estsamanthazota-cmd/Laboratorio-1-Robotica-UMNG/OperadorHumano/README.md

En este apartado se encontrara el diagrama de bloques correspondiente a la interfaz grafica del proceso del ensamble

Se encuentran las señales de inicio de la secuencia como el home de cada uno de los manipuladores.

Se monitorea cada una de los procesos realizados por los ensambladores como de los transportadores.

Se evalua el estado de la caja como de los pin pones
