estsamanthazota-cmd/Laboratorio-1-Robotica-UMNG/OperadorHumano/DiagramaDeBloques.pdf

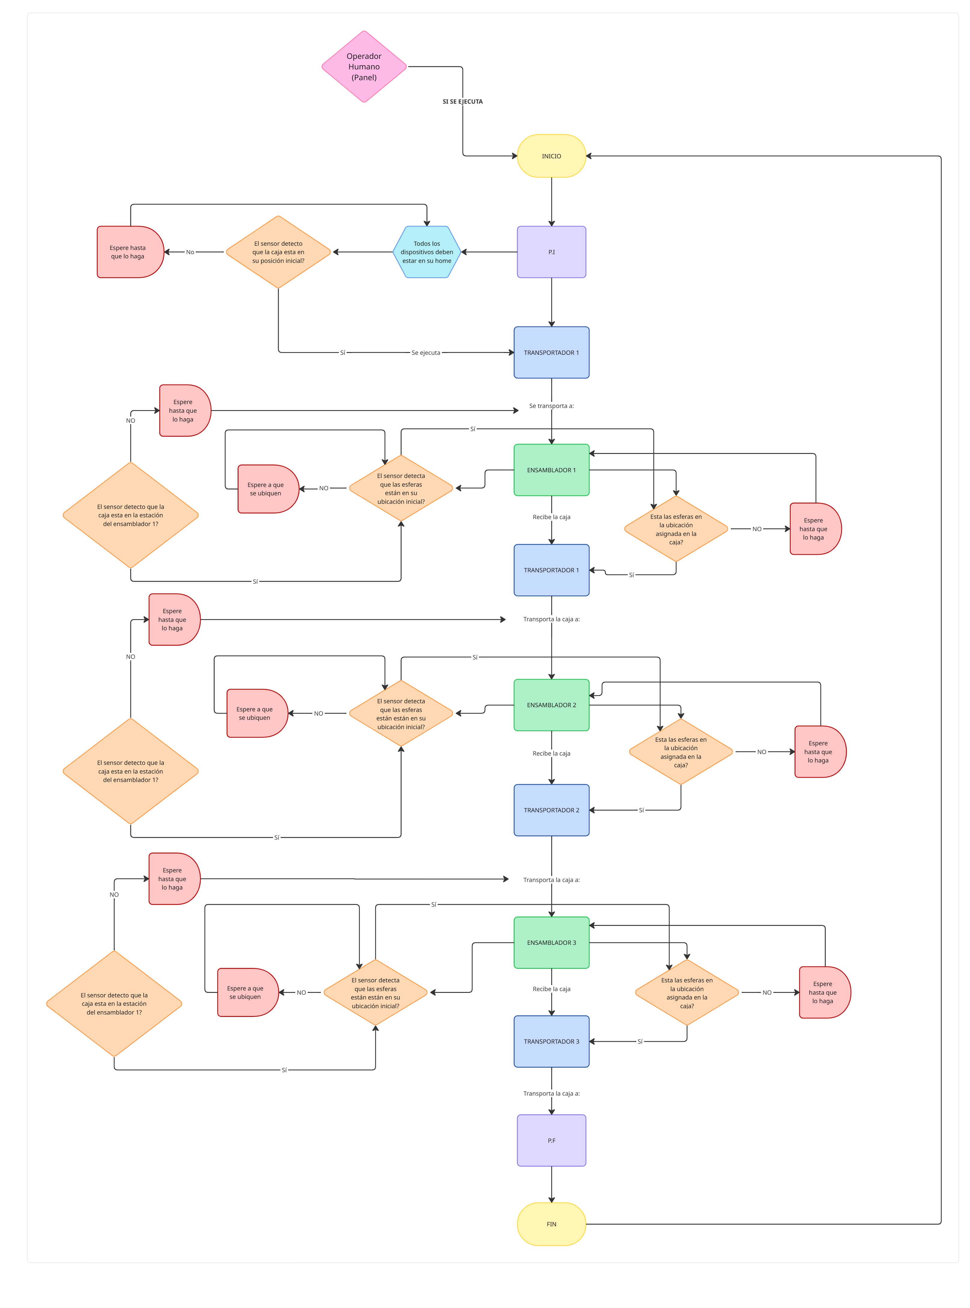
[picture p3: page 1]
