estsamanthazota-cmd/Laboratorio-1-Robotica-UMNG/Transportador 1/Brazo/Planos/Planos Brazo Robotico.pdf

TRANSPORTADOR N° 1

Hecho por:

Johan Nicolas Moreno Sabogal

Juan David Romero Prieto

Juan Esteban Betancourt Amado

Samir Esteban Jiménez Arias

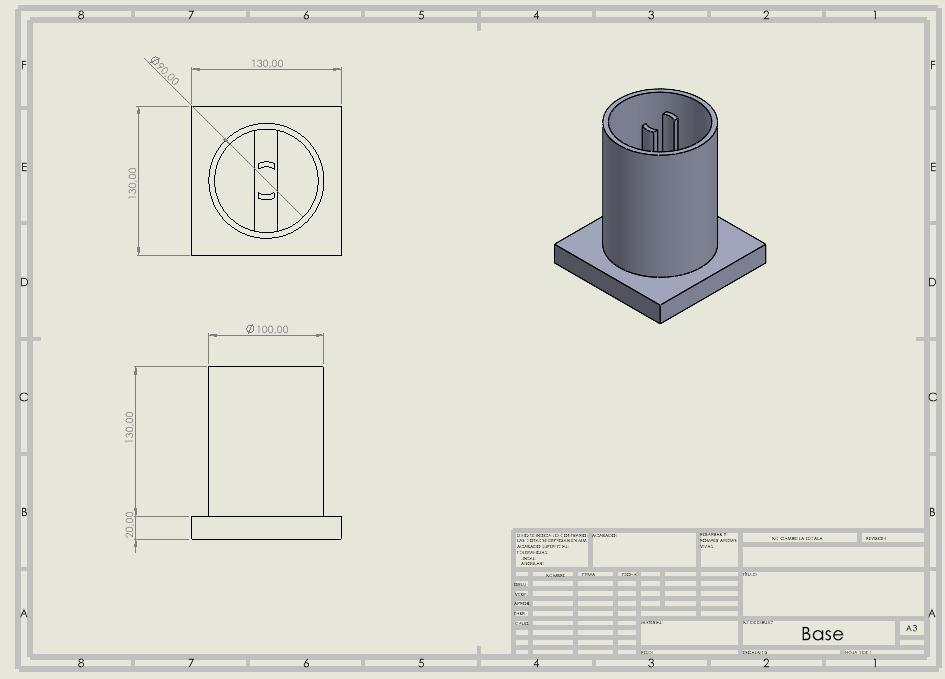
[picture p4: page 2]
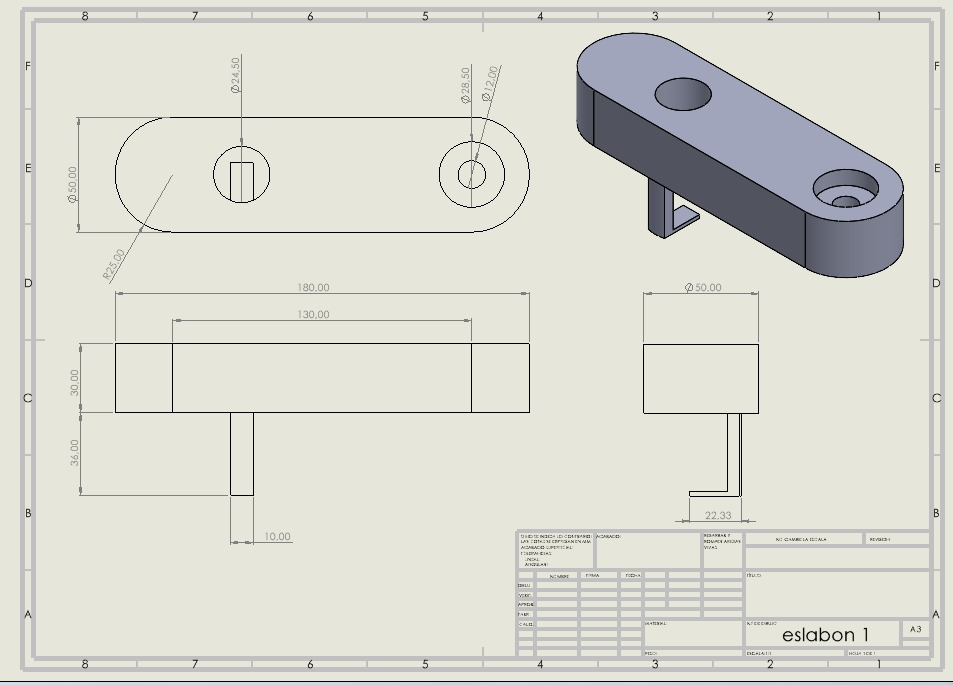
[picture p5: page 3]
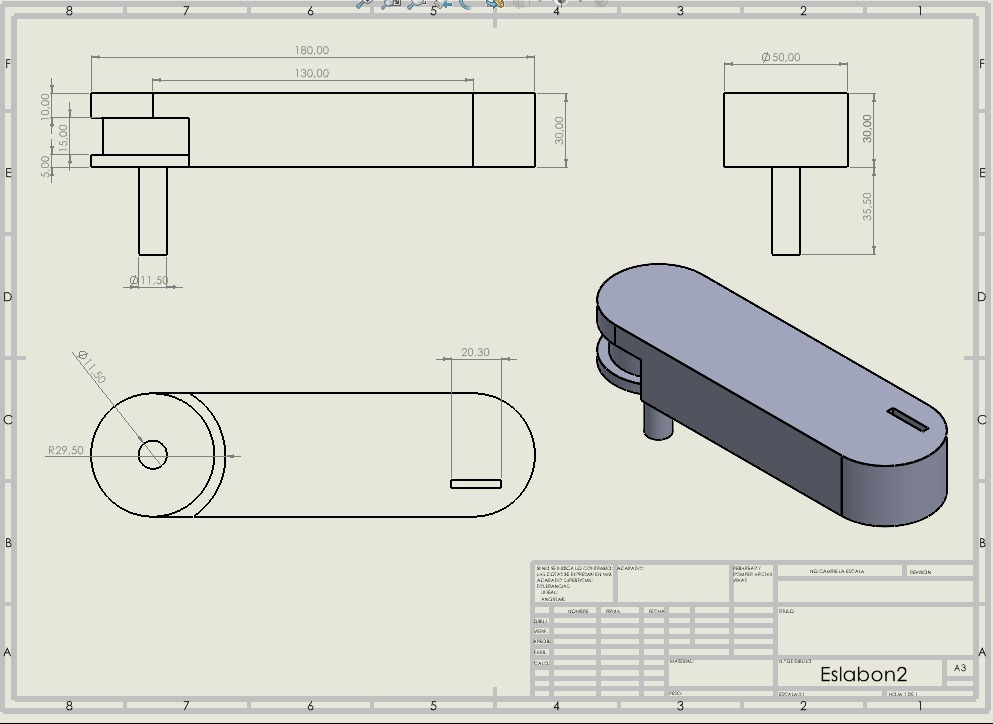
[picture p6: page 4]
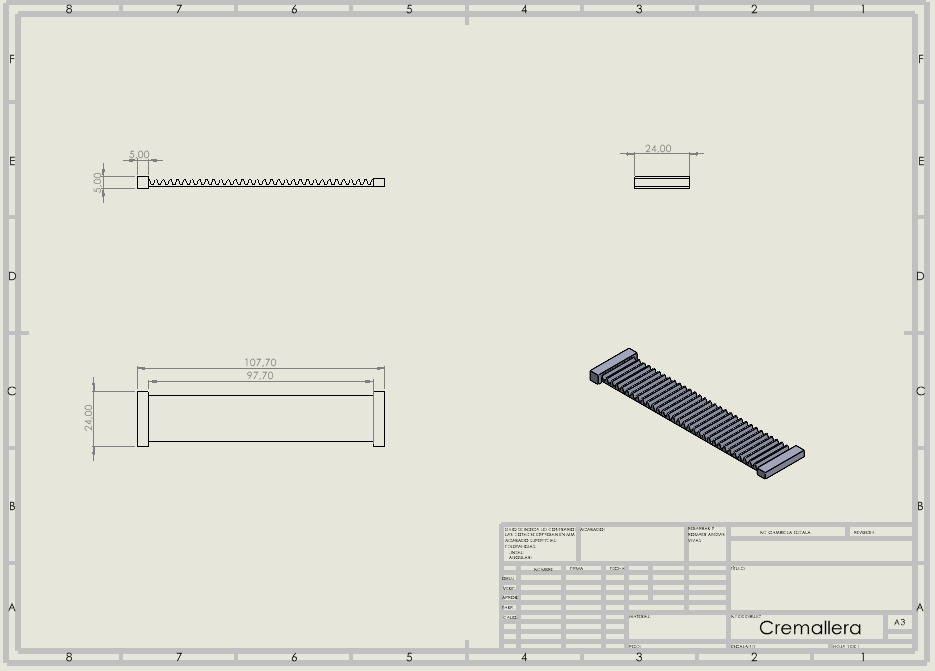
[picture p7: page 5]
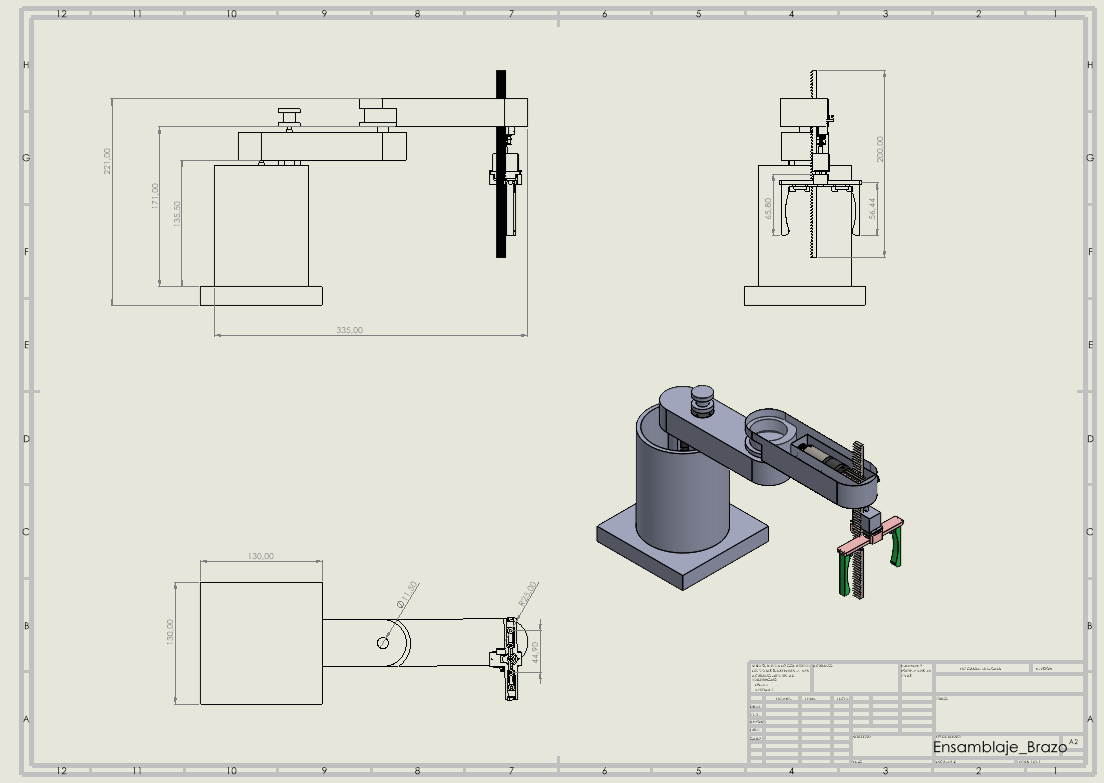
[picture p8: page 6]
