estsamanthazota-cmd/Laboratorio-1-Robotica-UMNG/Ensamblador1/Gazebo/install/urdf_test/share/ATEM6/meshes/LINK2.STL

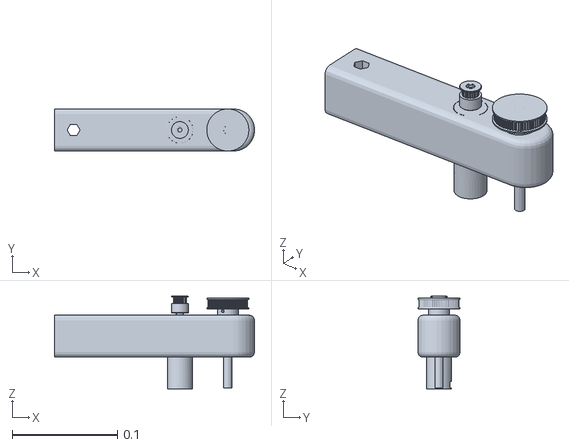
[picture p9: CAD file, 2026-03-19]
Ensamblador1/Gazebo/install/urdf_test/share/ATEM6/meshes/LINK2.STL
0.19 x 0.04 x 0.088
