estsamanthazota-cmd/Laboratorio-1-Robotica-UMNG/Ensamblador1/Gazebo/src/urdf_test/meshes/LINK3.STL

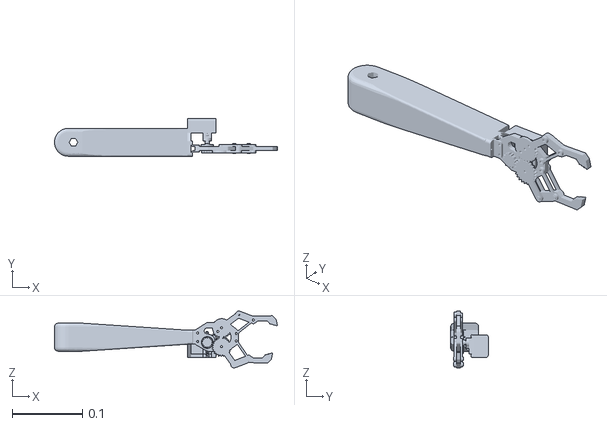
[picture p10: CAD file, 2026-03-19]
Ensamblador1/Gazebo/src/urdf_test/meshes/LINK3.STL
0.318 x 0.0536 x 0.0811
