estsamanthazota-cmd/Laboratorio-1-Robotica-UMNG/Transportador 1/Gazebo/Ensamblaje_Brazo_URDF/meshes/Link_Eslabon_2.STL

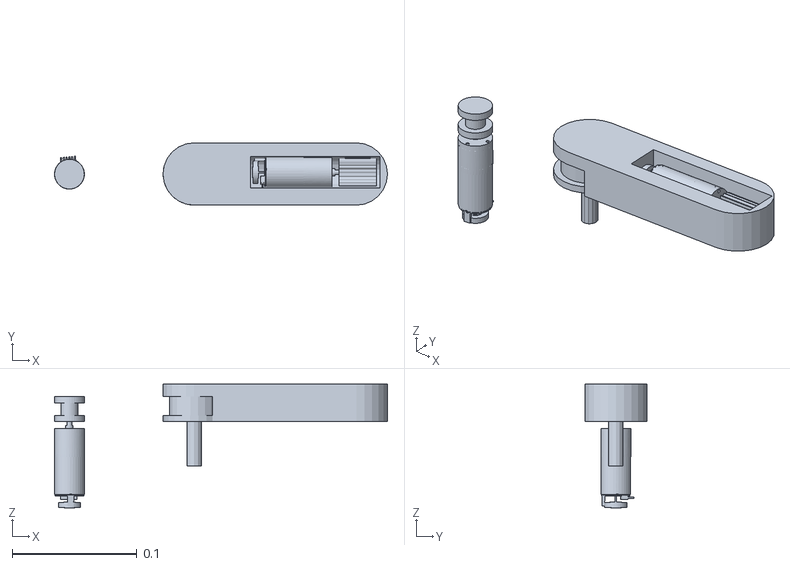
[picture p11: CAD file, 2026-03-19]
Transportador 1/Gazebo/Ensamblaje_Brazo_URDF/meshes/Link_Eslabon_2.STL
0.267 x 0.05 x 0.0993
