estsamanthazota-cmd/Laboratorio-1-Robotica-UMNG/Ensamblador1/Gazebo/src/urdf_test/meshes/BASE.STL

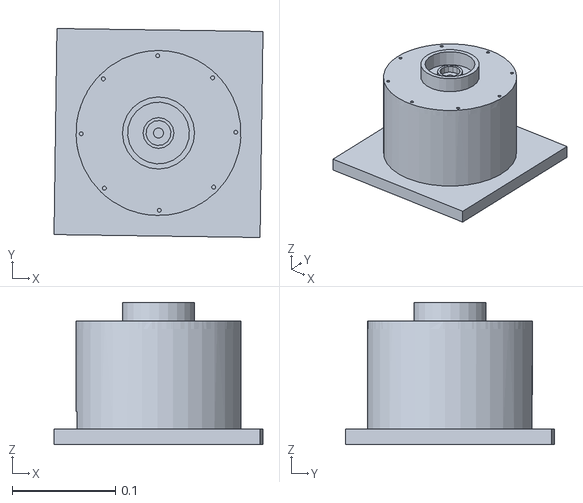
[picture p12: CAD file, 2026-03-19]
Ensamblador1/Gazebo/src/urdf_test/meshes/BASE.STL
0.203 x 0.203 x 0.138
