estsamanthazota-cmd/Laboratorio-1-Robotica-UMNG/Transportador 1/Gazebo/Ensamblaje_Brazo_URDF/meshes/Link_Gripper.STL

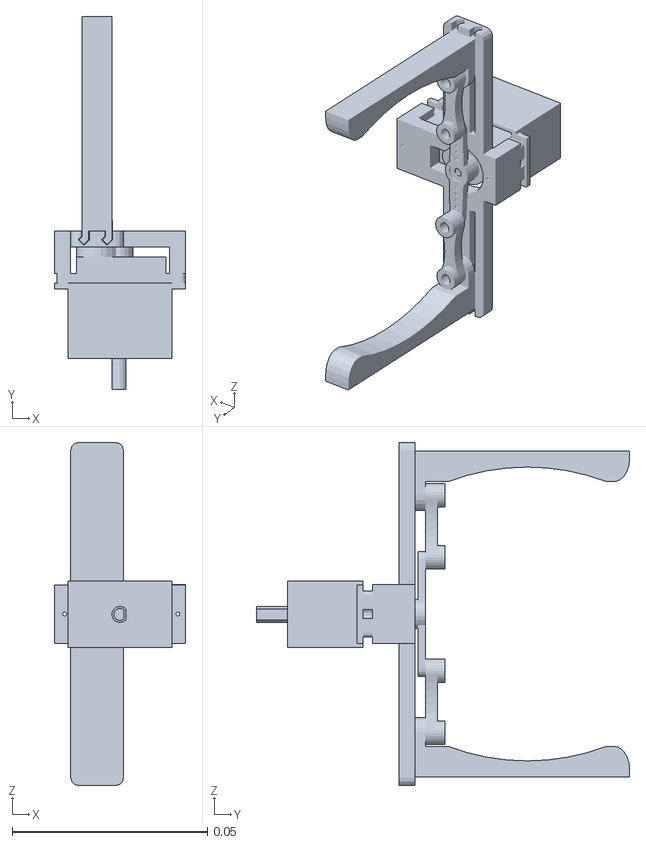
[picture p13: CAD file, 2026-03-19]
Transportador 1/Gazebo/Ensamblaje_Brazo_URDF/meshes/Link_Gripper.STL
0.0336 x 0.0956 x 0.0878
