estsamanthazota-cmd/Laboratorio-1-Robotica-UMNG/Ensamblador1/Gazebo/install/urdf_test/share/ATEM6/meshes/LINK1.STL

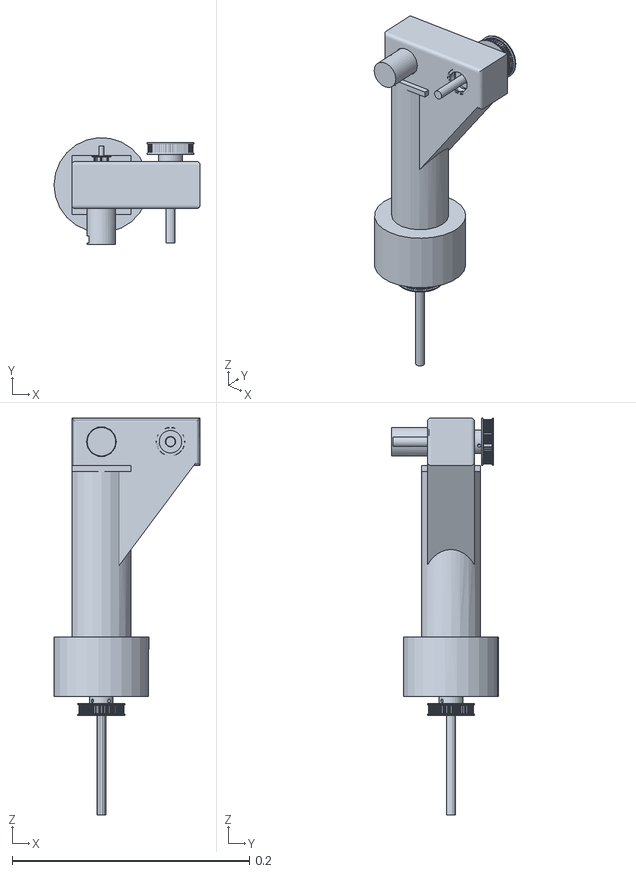
[picture p14: CAD file, 2026-03-19]
Ensamblador1/Gazebo/install/urdf_test/share/ATEM6/meshes/LINK1.STL
0.123 x 0.0899 x 0.335
