estsamanthazota-cmd/Laboratorio-1-Robotica-UMNG/Transportador 1/Gazebo/Ensamblaje_Brazo_URDF/meshes/Link_Eslabon_1.STL

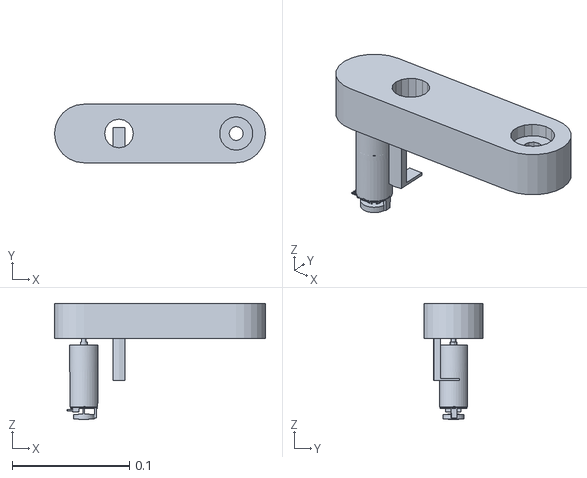
[picture p15: CAD file, 2026-03-19]
Transportador 1/Gazebo/Ensamblaje_Brazo_URDF/meshes/Link_Eslabon_1.STL
0.18 x 0.05 x 0.0992
