estsamanthazota-cmd/Laboratorio-1-Robotica-UMNG/Transportador 1/Gazebo/Ensamblaje_Brazo_URDF/meshes/Llink_Base.STL

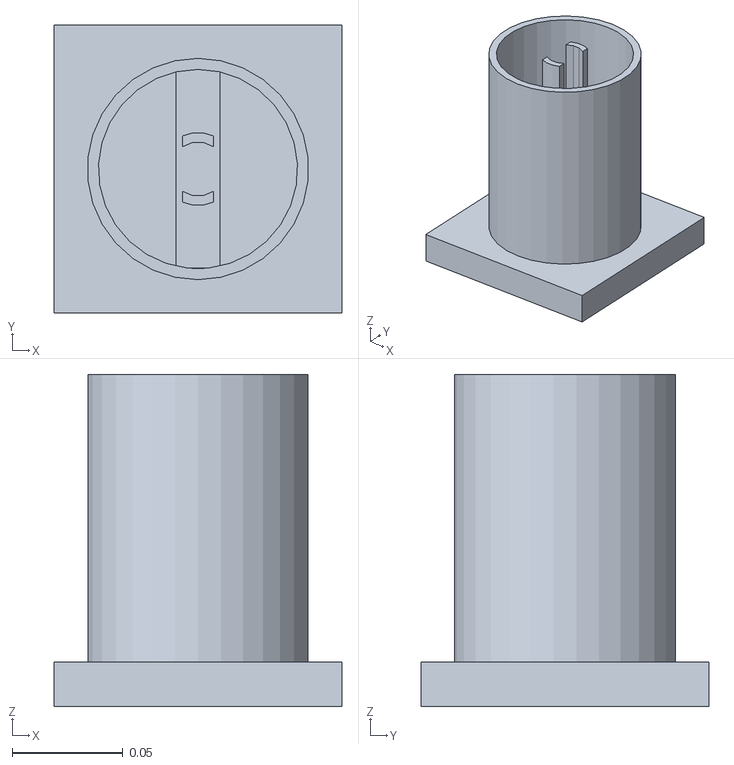
[picture p16: CAD file, 2026-03-19]
Transportador 1/Gazebo/Ensamblaje_Brazo_URDF/meshes/Llink_Base.STL
0.13 x 0.13 x 0.15
