estsamanthazota-cmd/Laboratorio-1-Robotica-UMNG/(list of files, cad)

Other CAD files:
Ensamblador1/Gazebo/install/urdf_test/share/urdf_test/ATEM6/meshes/BASE.STL
Ensamblador1/Gazebo/install/urdf_test/share/urdf_test/meshes/LINK2.STL
Ensamblador1/Gazebo/install/urdf_test/share/urdf_test/ATEM6/meshes/LINK1.STL
Ensamblador1/Gazebo/install/urdf_test/share/urdf_test/meshes/BASE.STL
Ensamblador1/Gazebo/install/urdf_test/share/urdf_test/ATEM6/meshes/LINK3.STL
Ensamblador1/Gazebo/install/urdf_test/share/urdf_test/meshes/LINK1.STL
Ensamblador1/Gazebo/install/urdf_test/share/urdf_test/ATEM6/meshes/LINK2.STL
Ensamblador1/Gazebo/install/urdf_test/share/urdf_test/meshes/LINK3.STL
