estsamanthazota-cmd/Laboratorio-1-Robotica-UMNG/Ensamblador1/README.md

Descripción

En este proyecto se encuentra el desarrollo del primer ensamblador en la cadena de ensamble de una caja con pin pones,
el cual se encuentra estructurado por simulación, diagrma de bloques, Cinematicas, Control y diseño mecatronico.

Integrantes:

Jose Manuel Diaz Amariles
Schneider Vivas Martinez
Juan Felipe Rodriguez Rios
Paula Andrea Torres Beltran

Estado del proyecto:

85%

Tecnologias Usadas:

ESP32
Arduino IDE
ROS2
Rviz
Gazebo
SolidWorks
