estsamanthazota-cmd/Laboratorio-1-Robotica-UMNG/Ensamblador1/Gazebo/build/urdf_test/symlink_install_manifest.txt

/home/schneider/ws_urdf/install/urdf_test/share/urdf_test/launch/display.launch.py
/home/schneider/ws_urdf/install/urdf_test/share/urdf_test/launch/gazebo.launch.py
/home/schneider/ws_urdf/install/urdf_test/share/urdf_test/launch/rviz.launch.py
/home/schneider/ws_urdf/install/urdf_test/share/urdf_test/urdf/model.urdf
/home/schneider/ws_urdf/install/urdf_test/share/urdf_test/meshes/BASE.STL
/home/schneider/ws_urdf/install/urdf_test/share/urdf_test/meshes/LINK1.STL
/home/schneider/ws_urdf/install/urdf_test/share/urdf_test/meshes/LINK2.STL
/home/schneider/ws_urdf/install/urdf_test/share/urdf_test/meshes/LINK3.STL
/home/schneider/ws_urdf/install/urdf_test/share/urdf_test/config/controllers.yaml
/home/schneider/ws_urdf/install/urdf_test/share/ament_index/resource_index/package_run_dependencies/urdf_test
/home/schneider/ws_urdf/install/urdf_test/share/ament_index/resource_index/parent_prefix_path/urdf_test
/home/schneider/ws_urdf/install/urdf_test/share/urdf_test/environment/ament_prefix_path.sh
/home/schneider/ws_urdf/install/urdf_test/share/urdf_test/environment/ament_prefix_path.dsv
/home/schneider/ws_urdf/install/urdf_test/share/urdf_test/environment/path.sh
/home/schneider/ws_urdf/install/urdf_test/share/urdf_test/environment/path.dsv
/home/schneider/ws_urdf/install/urdf_test/share/urdf_test/local_setup.bash
/home/schneider/ws_urdf/install/urdf_test/share/urdf_test/local_setup.sh
/home/schneider/ws_urdf/install/urdf_test/share/urdf_test/local_setup.zsh
/home/schneider/ws_urdf/install/urdf_test/share/urdf_test/local_setup.dsv
/home/schneider/ws_urdf/install/urdf_test/share/urdf_test/package.dsv
/home/schneider/ws_urdf/install/urdf_test/share/ament_index/resource_index/packages/urdf_test
/home/schneider/ws_urdf/install/urdf_test/share/urdf_test/cmake/urdf_testConfig.cmake
/home/schneider/ws_urdf/install/urdf_test/share/urdf_test/cmake/urdf_testConfig-version.cmake
/home/schneider/ws_urdf/install/urdf_test/share/urdf_test/package.xml
