estsamanthazota-cmd/Laboratorio-1-Robotica-UMNG/Ensamblador2/ENSAMBLE_SCARA.pdf

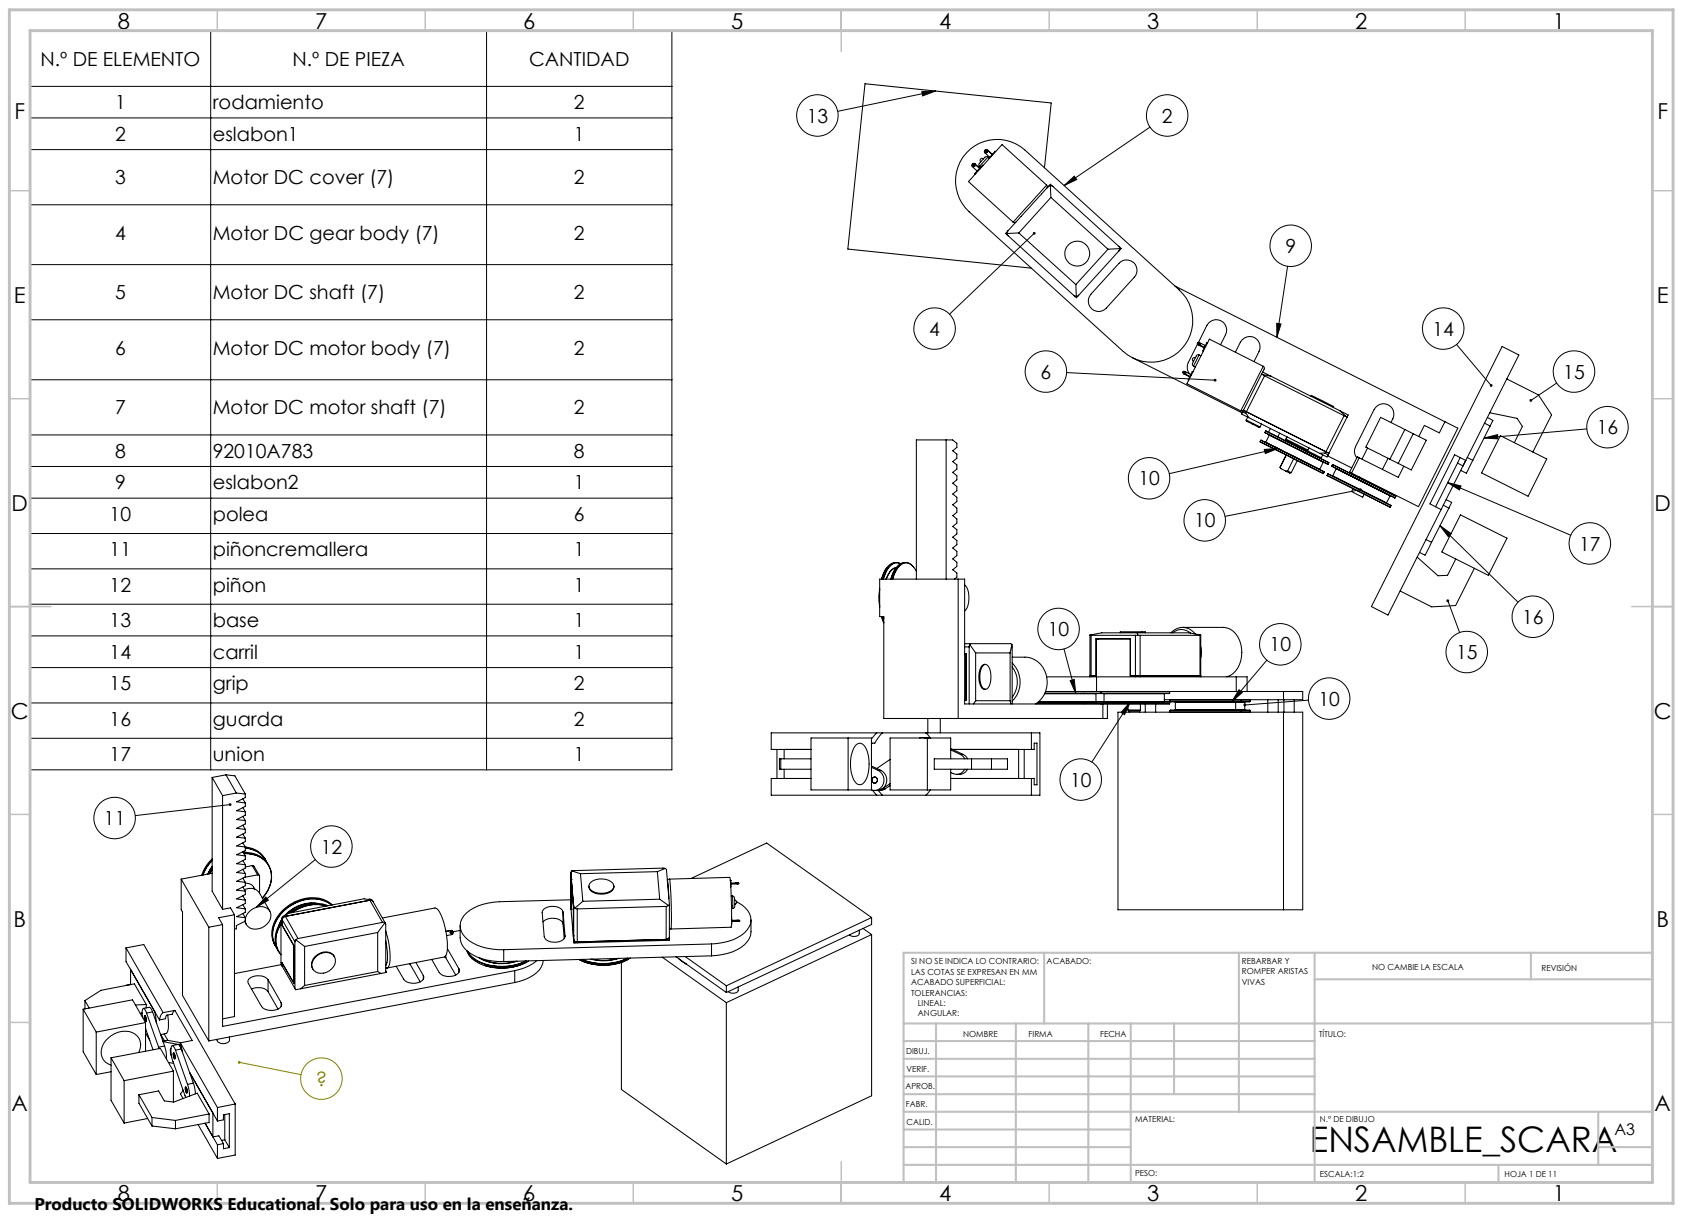
[picture p17: page 1]
ACABADO:; REBARBAR Y; ROMPER ARISTAS; NO CAMBIE LA ESCALA; REVISIÓN; ESCALA:1:2; HOJA 1 DE 11

N.º DE ELEMENTO | N.º DE PIEZA | CANTIDAD
1 | rodamiento | 2
2 | eslabon1 | 1
3 | Motor DC cover (7) | 2

4 | Motor DC gear body (7) | 2

5 | Motor DC shaft (7) | 2

6 | Motor DC motor body (7) | 2

7 | Motor DC motor shaft (7) | 2
8 | 92010A783 | 8
9 | eslabon2 | 1
10 | polea | 6
11 | piñoncremallera | 1
12 | piñon | 1
13 | base | 1
14 | carril | 1
15 | grip | 2
16 | guarda | 2
17 | union | 1

SI NO SE INDICA LO CONTRARIO:
LAS COTAS SE EXPRESAN EN MM
ACABADO SUPERFICIAL:
TOLERANCIAS:
LINEAL:
ANGULAR:

NOMBRE | FIRMA | FECHA | | | | TÍTULO:

DIBUJ.
VERIF.
APROB.
FABR.
CALID. | | | | MATERIAL: ENSAMBLE_SCARA | N.º DE DIBUJO | A3

Producto SOLIDWORKS Educational. Solo para uso en la enseñanza.

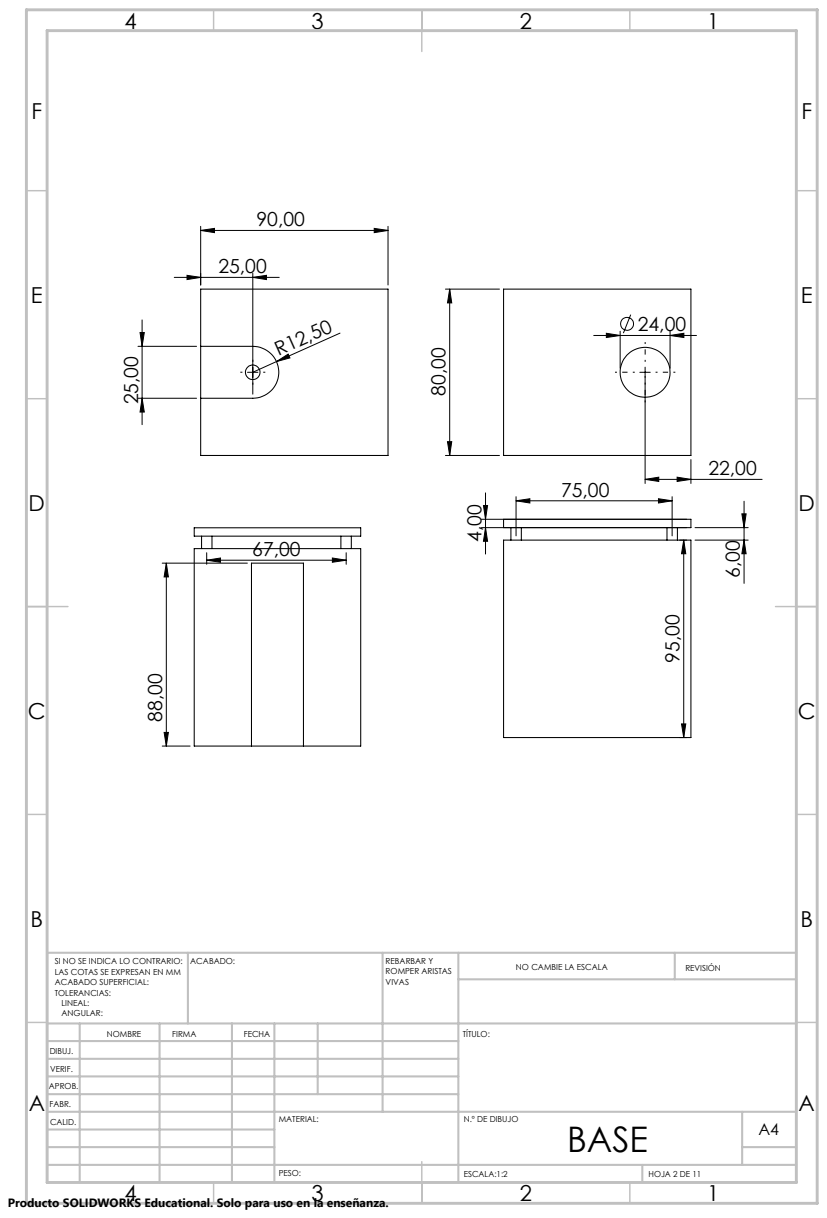
[picture p18: page 2]
ACABADO:; REBARBAR Y; ROMPER ARISTAS; NO CAMBIE LA ESCALA; REVISIÓN

SI NO SE INDICA LO CONTRARIO:
LAS COTAS SE EXPRESAN EN MM
ACABADO SUPERFICIAL:
TOLERANCIAS:
LINEAL:
ANGULAR:

NOMBRE | FIRMA | FECHA | | | TÍTULO:

DIBUJ.
VERIF.
APROB.
FABR.

BASE

ESCALA:1:2 | HOJA 2 DE 11

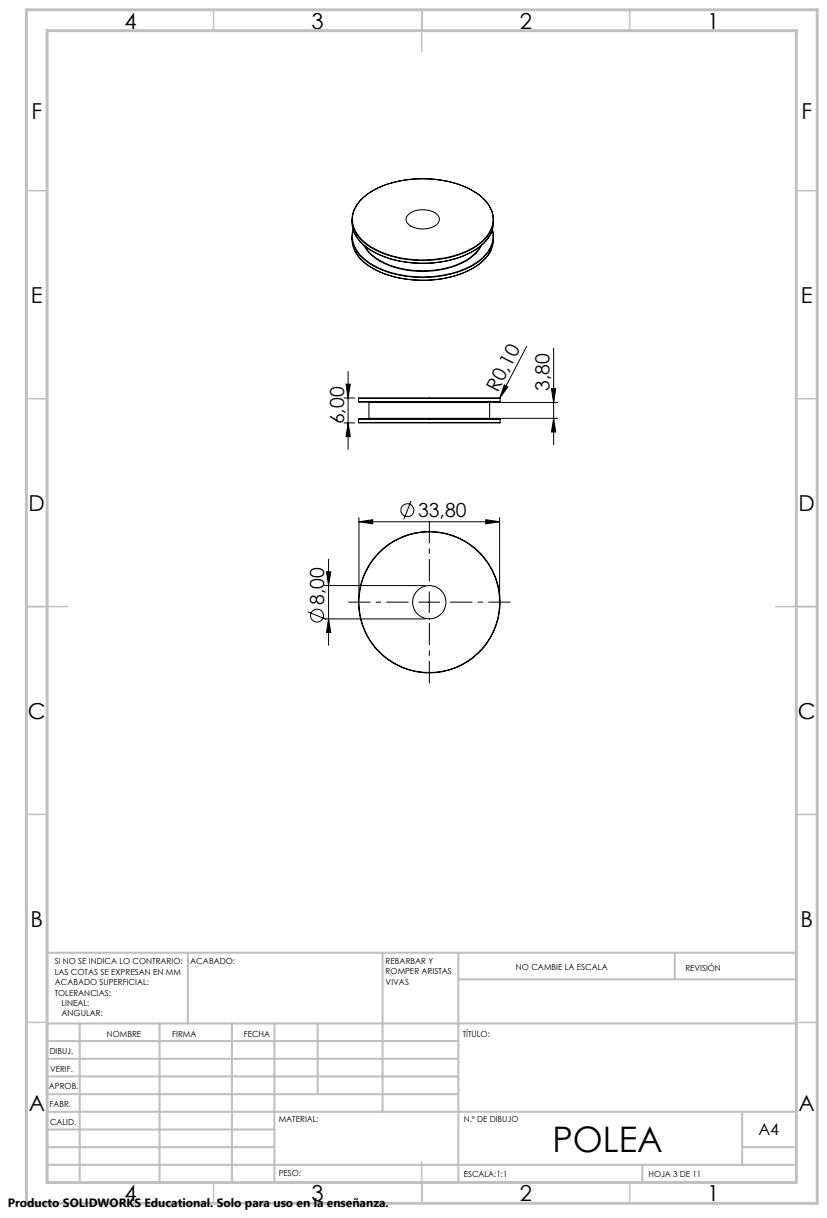
[picture p19: page 3]
ACABADO:; REBARBAR Y; ROMPER ARISTAS; NO CAMBIE LA ESCALA; REVISIÓN

SI NO SE INDICA LO CONTRARIO:
LAS COTAS SE EXPRESAN EN MM
ACABADO SUPERFICIAL:
TOLERANCIAS:
LINEAL:
ANGULAR:

NOMBRE | FIRMA | FECHA | | | TÍTULO:

DIBUJ.
VERIF.
APROB.
FABR.

POLEA

ESCALA:1:1 | HOJA 3 DE 11

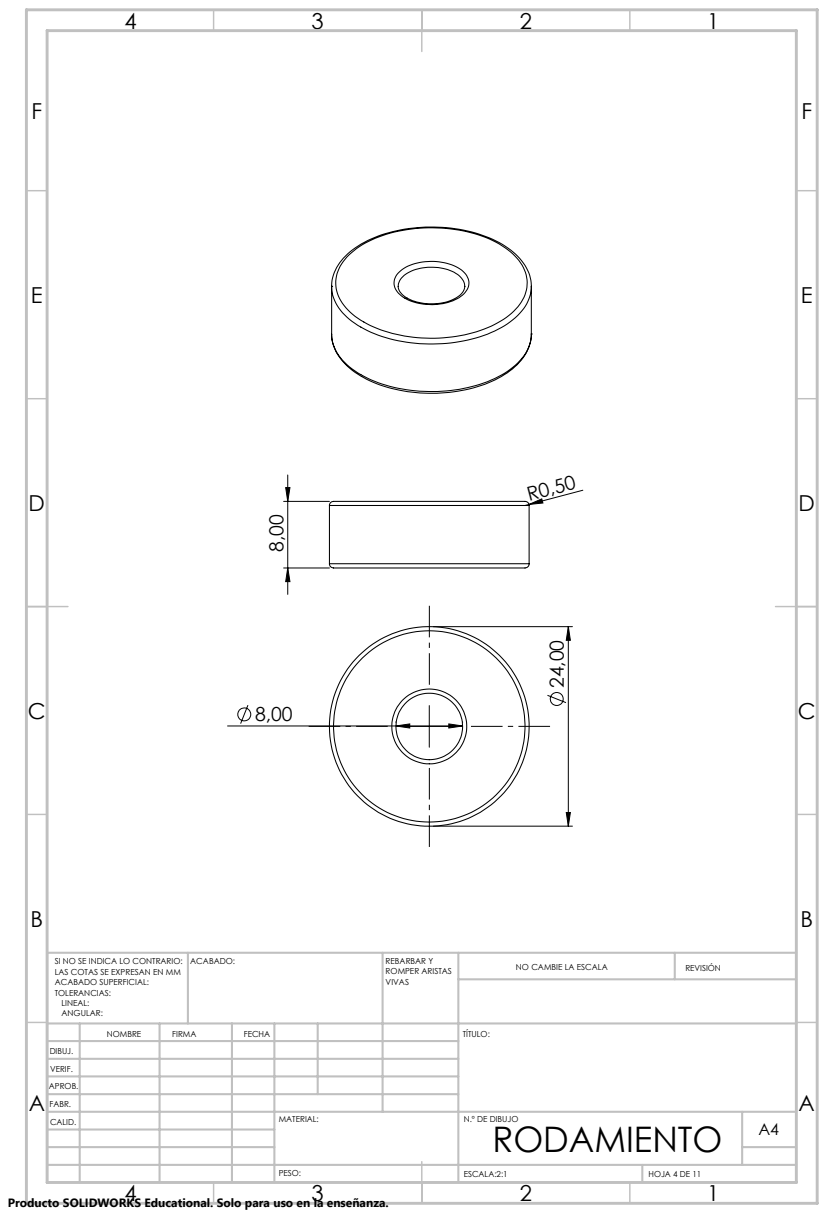
[picture p20: page 4]
ACABADO:; REBARBAR Y; ROMPER ARISTAS; NO CAMBIE LA ESCALA; REVISIÓN

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

NOMBRE | FIRMA | FECHA | | | TÍTULO:

DIBUJ.
VERIF.
APROB.
FABR.

RODAMIENTO

ESCALA:2:1 | HOJA 4 DE 11

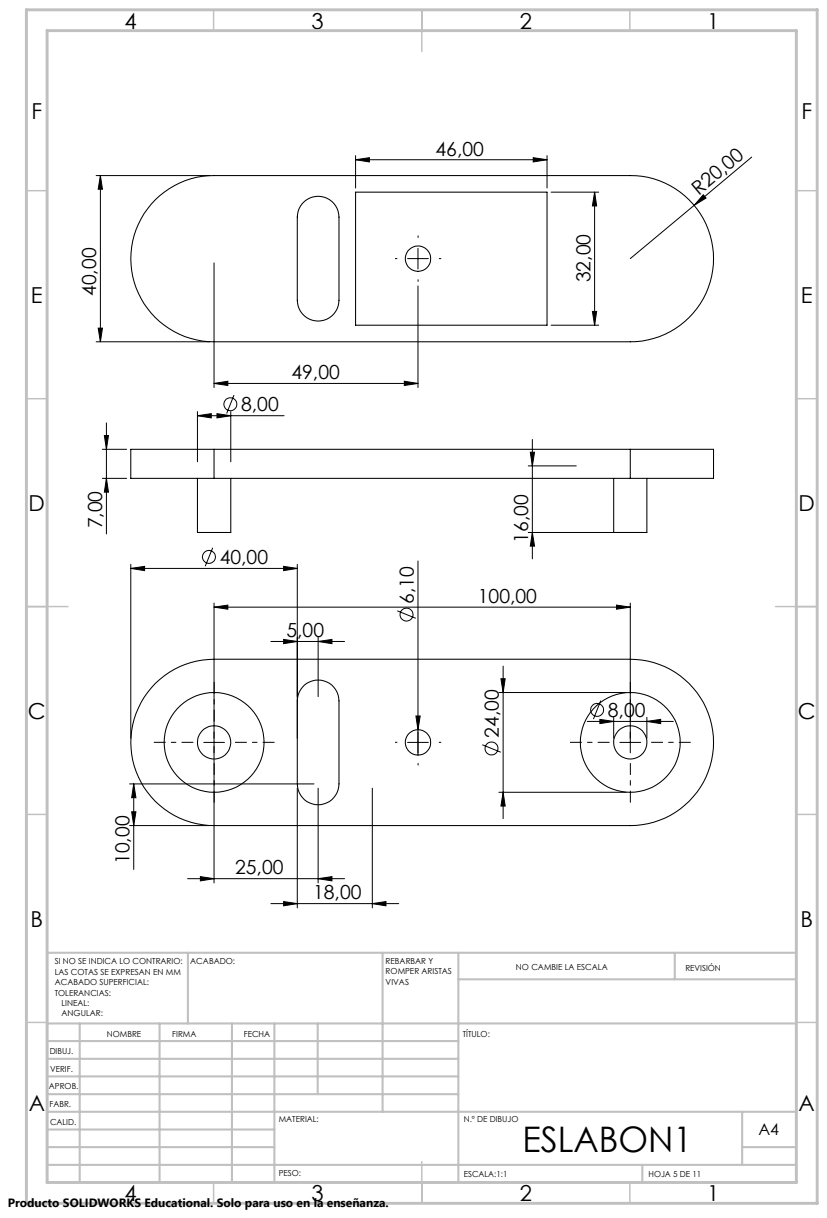
[picture p21: page 5]
ACABADO:; REBARBAR Y; ROMPER ARISTAS; NO CAMBIE LA ESCALA; REVISIÓN

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

NOMBRE | FIRMA | FECHA | | TÍTULO:

DIBUJ.
VERIF.
APROB.
FABR.

ESLABON1

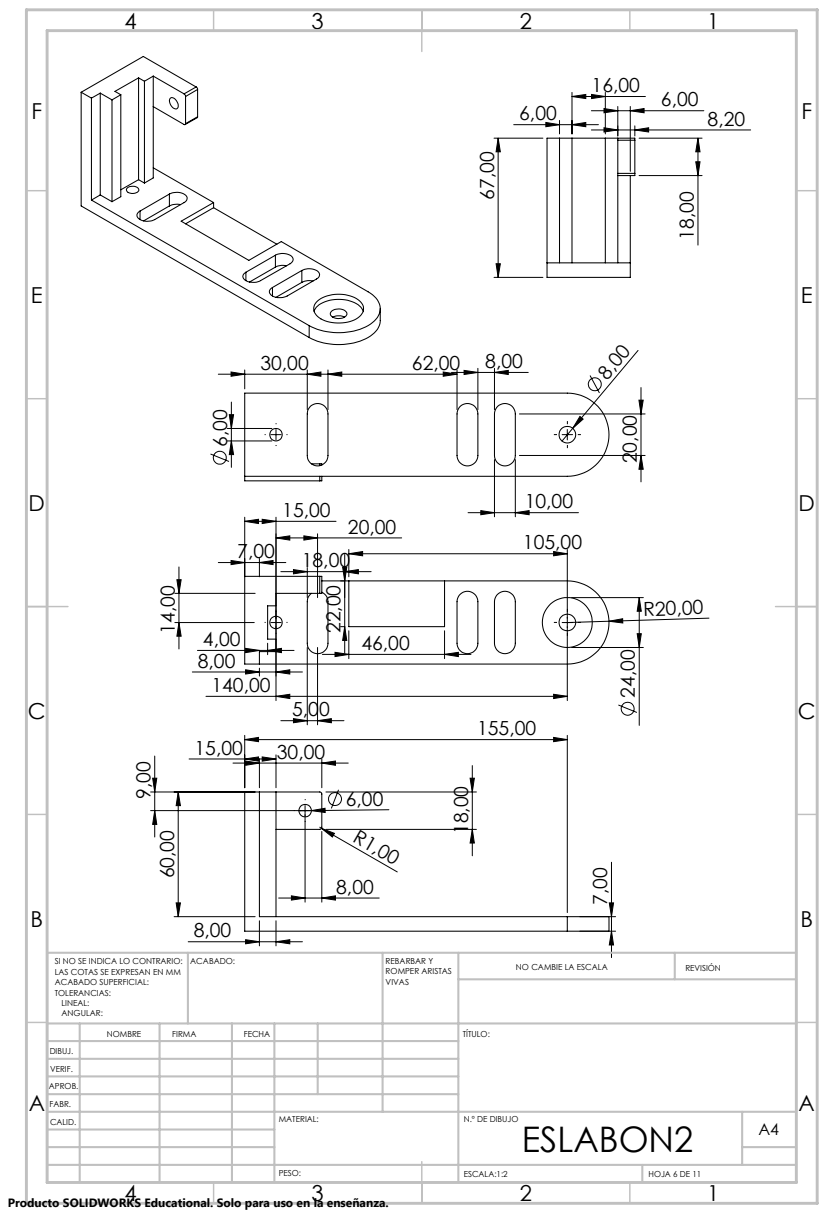
[picture p22: page 6]
ACABADO:; REBARBAR Y; ROMPER ARISTAS; NO CAMBIE LA ESCALA; REVISIÓN

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

NOMBRE | FIRMA | FECHA | | | TÍTULO:

DIBUJ.
VERIF.
APROB.
FABR.

ESLABON2

ESCALA:1:2 | HOJA 6 DE 11

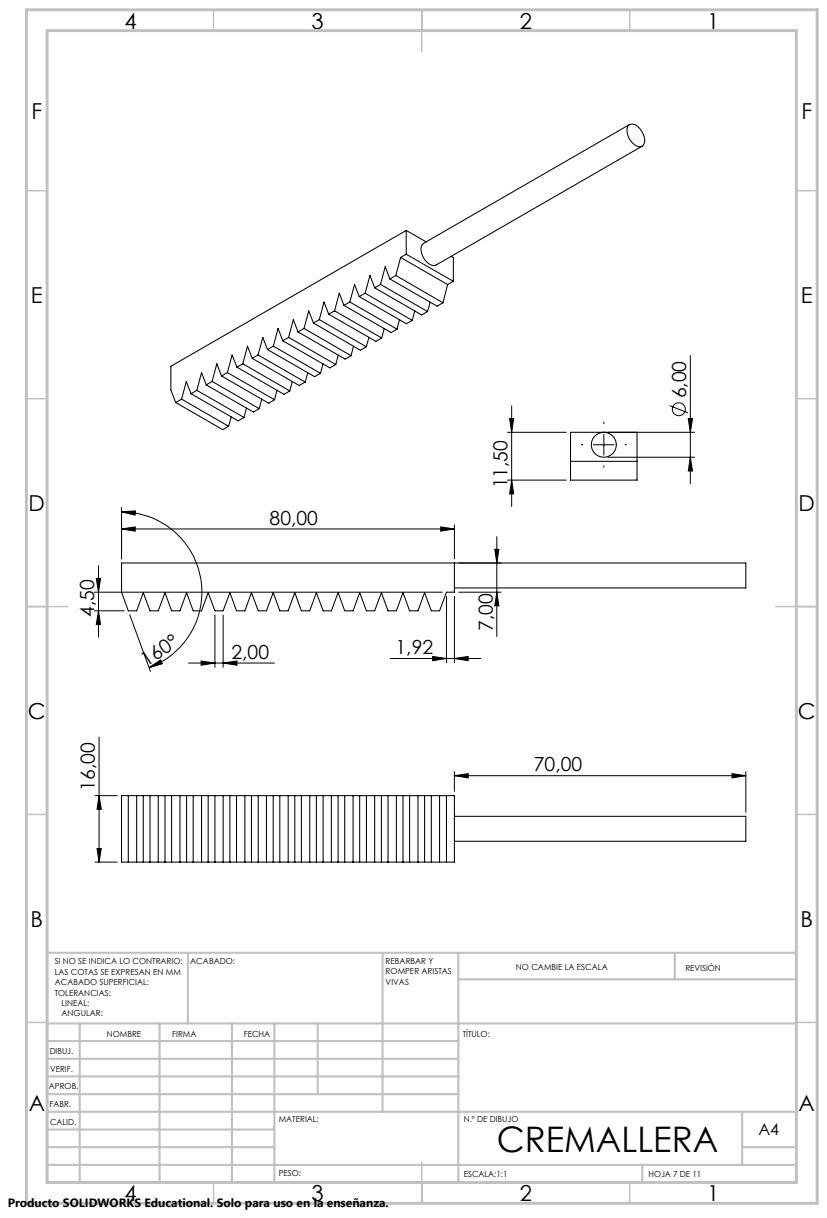
[picture p23: page 7]
ACABADO:; REBARBAR Y; ROMPER ARISTAS; NO CAMBIE LA ESCALA; REVISIÓN

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

NOMBRE | FIRMA | FECHA | | TÍTULO:

DIBUJ.
VERIF.
APROB.
FABR.

CREMALLERA

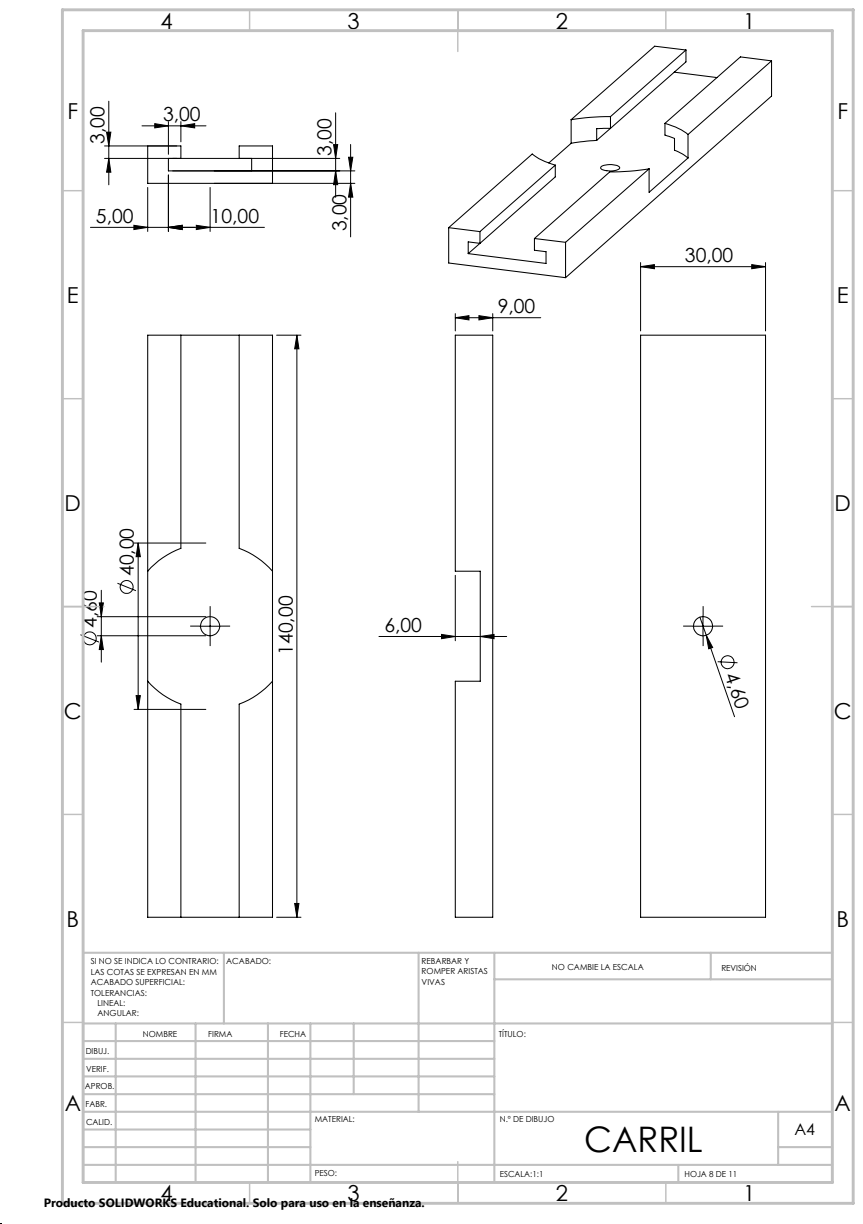
[picture p24: page 8]
ACABADO:; REBARBAR Y; ROMPER ARISTAS; NO CAMBIE LA ESCALA; REVISIÓN

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

NOMBRE | FIRMA | FECHA | | TÍTULO:

DIBUJ.
VERIF.
APROB.
FABR.

CARRIL

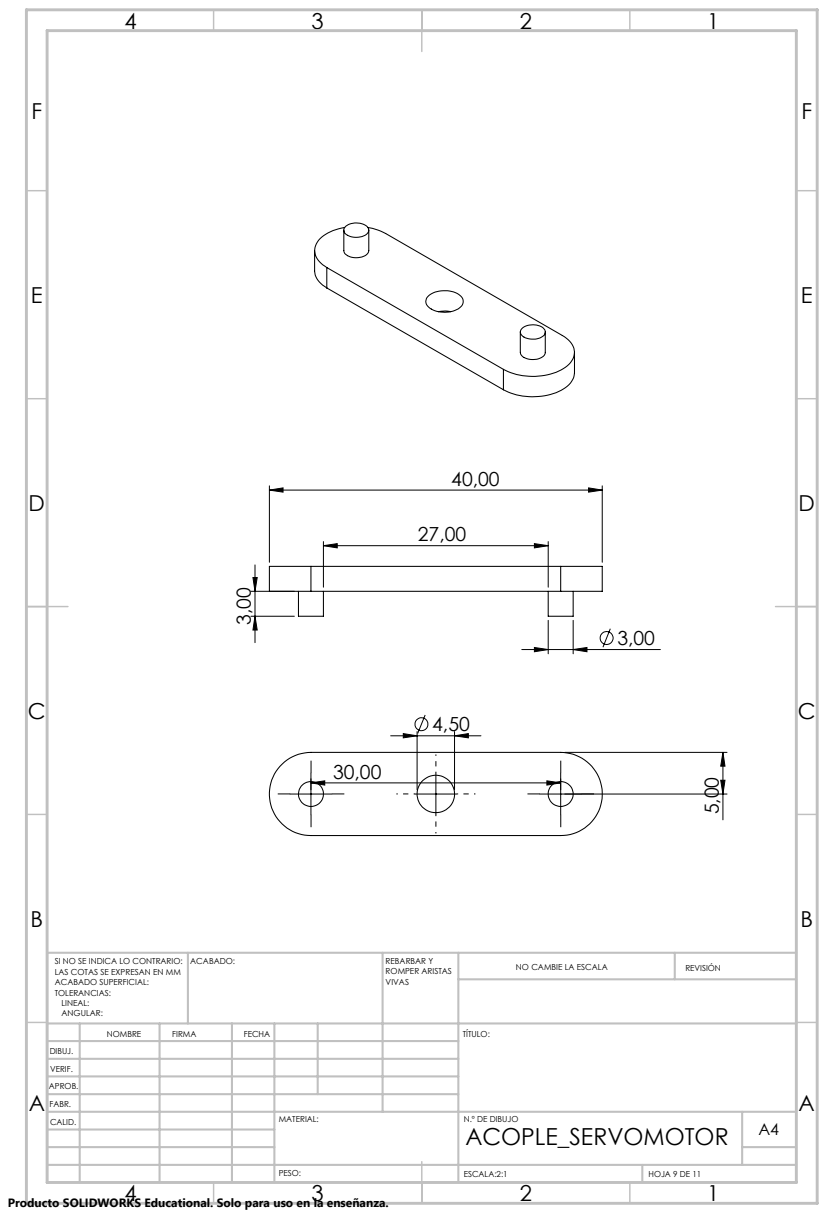
[picture p25: page 9]
ACABADO:; REBARBAR Y; ROMPER ARISTAS; NO CAMBIE LA ESCALA; REVISIÓN

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

NOMBRE | FIRMA | FECHA | | | TÍTULO:

DIBUJ.
VERIF.
APROB.
FABR.

ACOPLE_SERVOMOTOR

ESCALA:2:1 | HOJA 9 DE 11

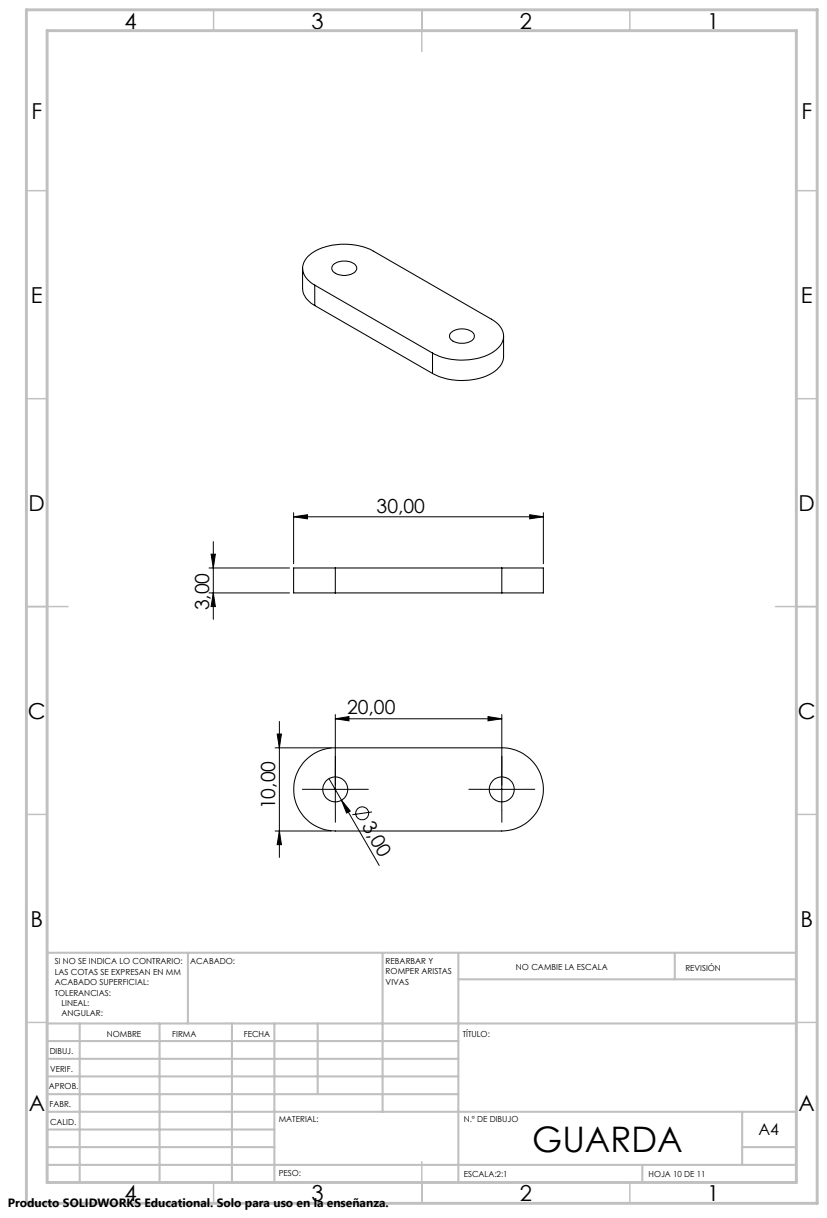
[picture p26: page 10]
ACABADO:; REBARBAR Y; ROMPER ARISTAS; NO CAMBIE LA ESCALA; REVISIÓN

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

NOMBRE | FIRMA | FECHA | | | TÍTULO:

DIBUJ.
VERIF.
APROB.
FABR.

GUARDA

ESCALA:2:1 | HOJA 10 DE 11

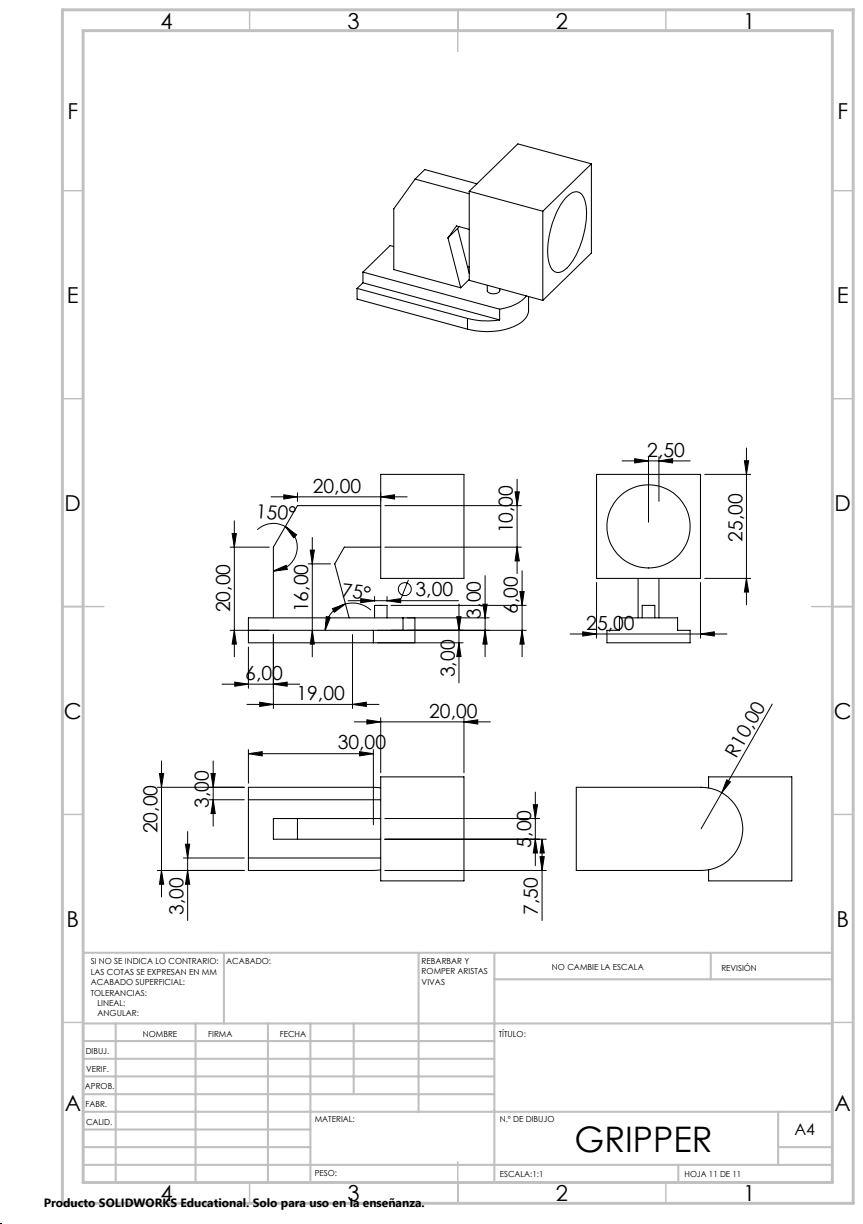
[picture p27: page 11]
ACABADO:; REBARBAR Y; ROMPER ARISTAS; NO CAMBIE LA ESCALA; REVISIÓN

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

NOMBRE | FIRMA | FECHA | | TÍTULO:

DIBUJ.
VERIF.
APROB.
FABR.

GRIPPER
