estsamanthazota-cmd/Laboratorio-1-Robotica-UMNG/Ensamblador3/Diagramadebloques/Diagramadebloque.jpeg

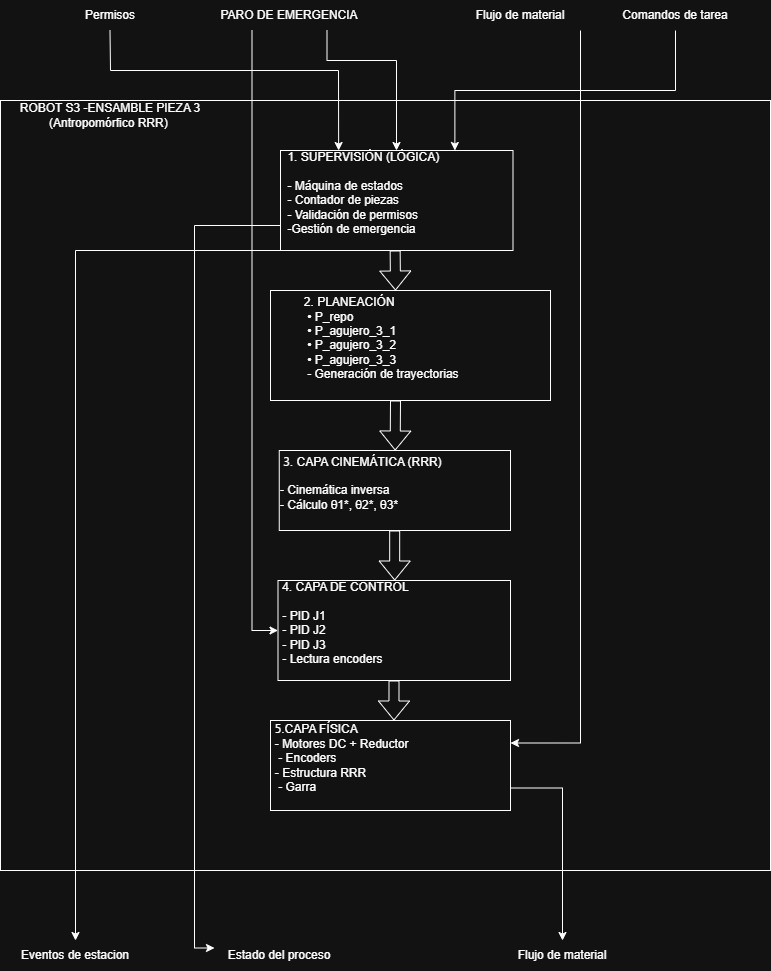
Ensamblador3/Diagramadebloques/Diagramadebloque.jpeg
