estsamanthazota-cmd/Laboratorio-1-Robotica-UMNG/Ensamblador2/Diagrama de Bloques Ensamblador 2.pdf

# Robot S2

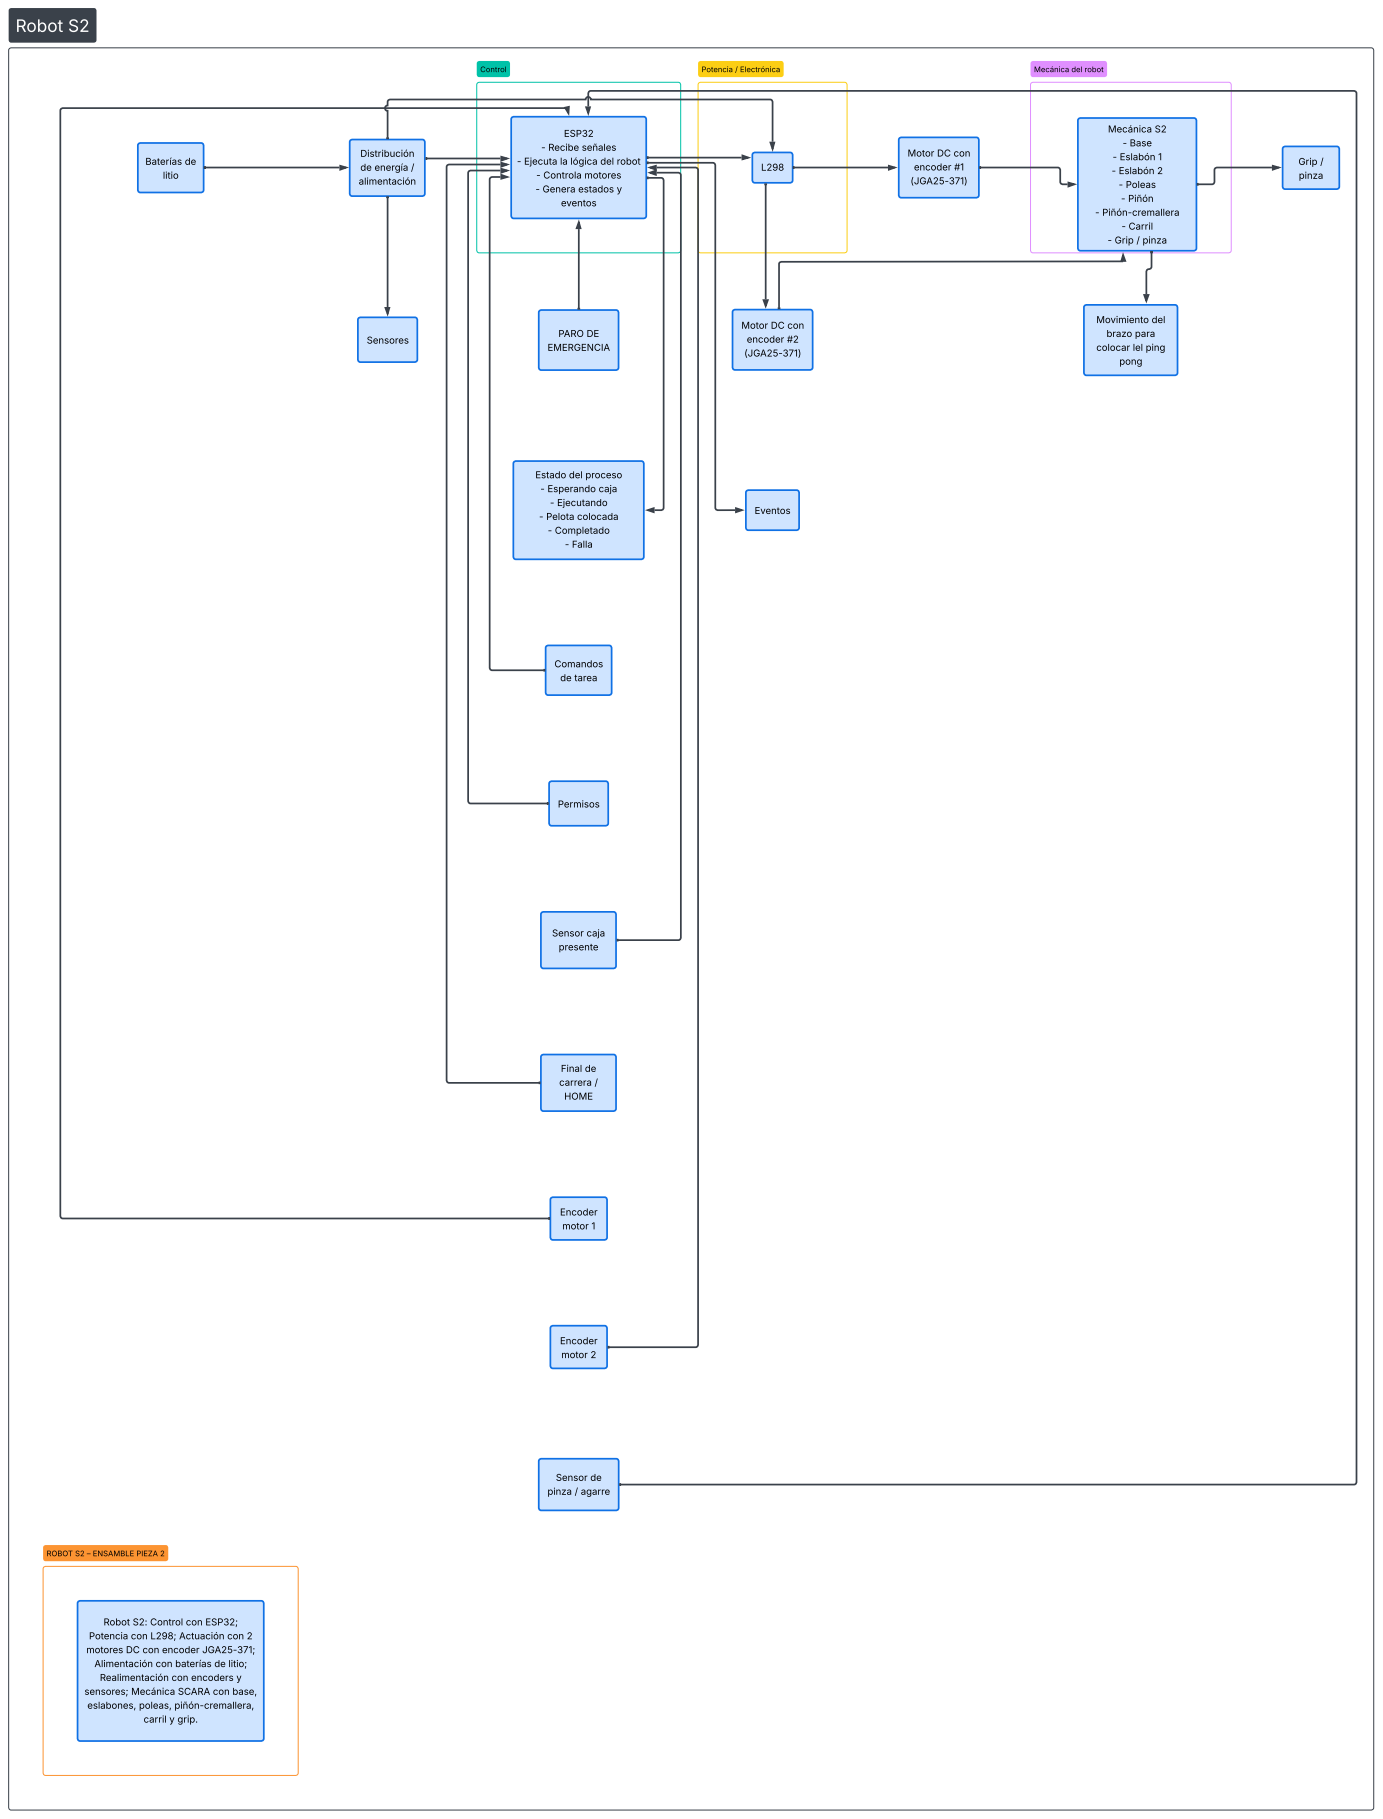
[picture p29: page 1]
Control; Potencia / Electrónica; Mecánica del robot; Mecánica S2 - Base - Eslabón 1 - Eslabón 2 - Poleas - Piñón - Piñón- cremallera - Carril - Grip / pinza; carril y grip.; PARO DE EMERGENCIA; Comandos de tarea; Permisos; Sensor caja presente; Final de carrera / HOME; Encoder motor 1; Encoder motor 2; Sensor de pinza / agarre; Baterías de litio; Distribución de energía / alimentación; Sensores; Motor DC con encoder #1 (JGA25-371); Motor DC con encoder #2 (JGA25-371); Grip / pinza; Eventos

ESP32
- Recibe señales
- Ejecuta la lógica del robot
- Controla motores
- Genera estados y
eventos

Movimiento del
brazo para
colocar lel ping
pong

Estado del proceso
- Esperando caja
- Ejecutando
- Pelota colocada
- Completado
- Falla

ROBOT S2 ? ENSAMBLE PIEZA 2

Robot S2: Control con ESP32;
Potencia con L298; Actuación con 2
motores DC con encoder JGA25-371;
Alimentación con baterías de litio;
Realimentación con encoders y
sensores; Mecánica SCARA con base,
eslabones, poleas, piñón- cremallera,
