estsamanthazota-cmd/Laboratorio-1-Robotica-UMNG/Ensamblador2/Paro de Emergencia.pdf

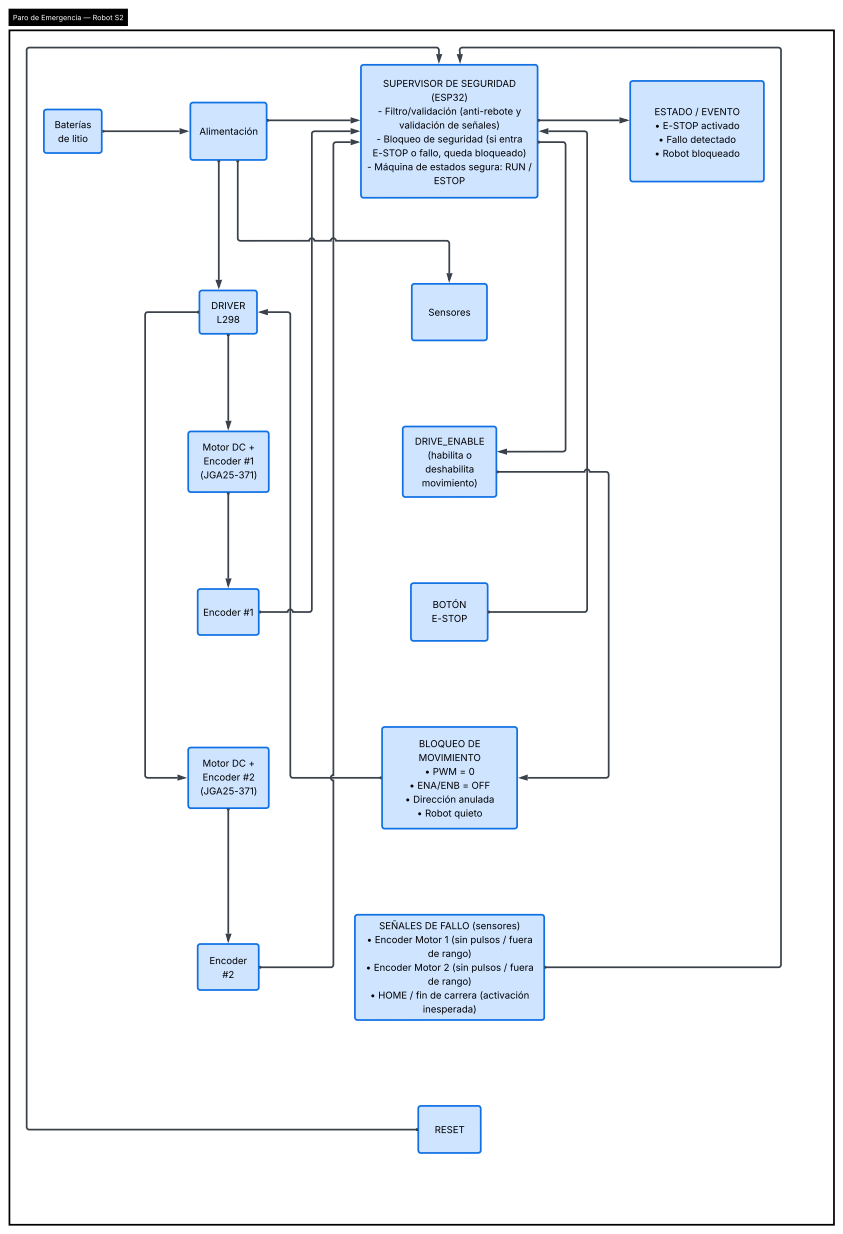
[picture p30: page 1]
BOTÓN E-STOP; de rango); inesperada); RESET; (ESP32); ESTOP; DRIVE_ENABLE (habilita o deshabilita movimiento); DRIVER L298; Motor DC + Encoder #1 (JGA25-371); Motor DC + Encoder #2 (JGA25-371); Encoder #1; Encoder #2; Baterías de litio; Alimentación; Sensores; ESTADO / EVENTO - E-STOP activado - Fallo detectado - Robot bloqueado

Paro de Emergencia ? Robot S2

SUPERVISOR DE SEGURIDAD

- Filtro/validación (anti-rebote y
validación de señales)
- Bloqueo de seguridad (si entra
E-STOP o fallo, queda bloqueado)
- Máquina de estados segura: RUN /

BLOQUEO DE
MOVIMIENTO
- PWM = 0
- ENA/ENB = OFF
- Dirección anulada
- Robot quieto

SEÑALES DE FALLO (sensores)
- Encoder Motor 1(sin pulsos / fuera

- Encoder Motor 2 (sin pulsos / fuera

- HOME / fin de carrera (activación
