estsamanthazota-cmd/Laboratorio-1-Robotica-UMNG/Ensamblador1/Diagrama en blanco.pdf

# Ensamblador E1

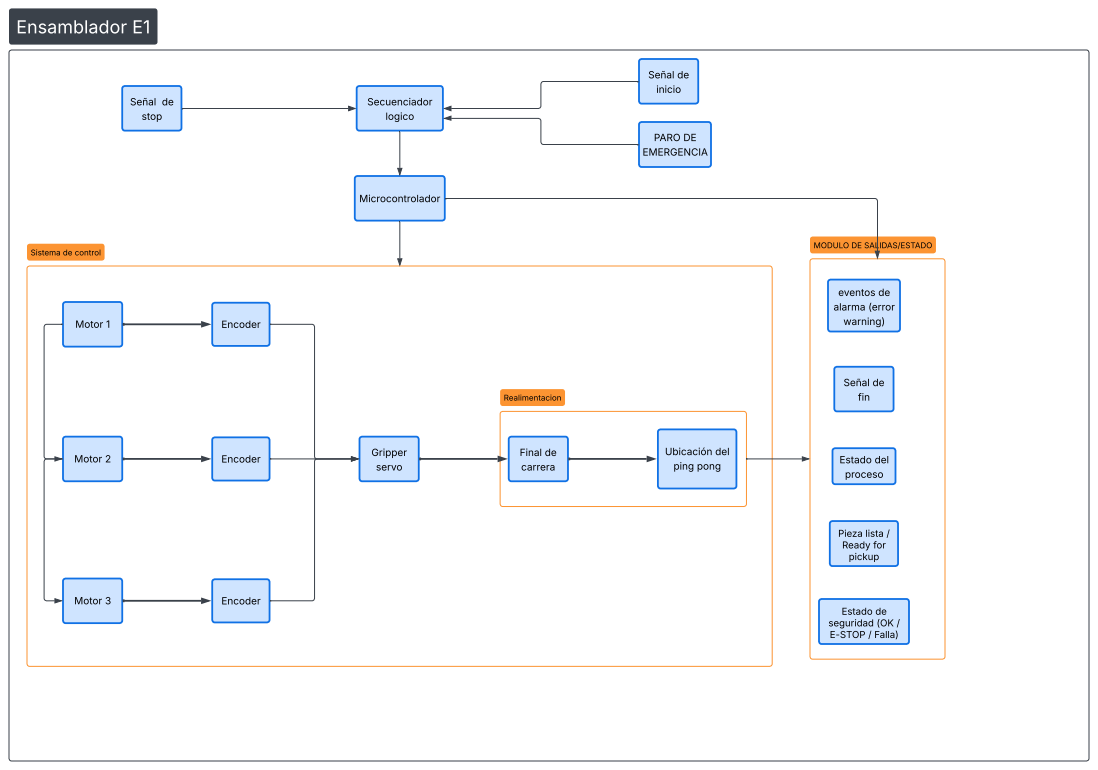
[picture p31: page 1]
Realimentacion; Señal de inicio; Motor 1; Encoder; Motor 2; Motor 3; Gripper servo; Final de carrera; Ubicación del ping pong; Secuenciador logico; Microcontrolador; Señal de fin; Señal de stop; PARO DE EMERGENCIA; Estado del proceso; eventos de alarma (error warning); Pieza lista / Ready for pickup; Estado de seguridad (OK / E-STOP / Falla)

MODULO DE SALIDAS/ESTADO

Sistema de control
