estsamanthazota-cmd/Laboratorio-1-Robotica-UMNG/Transportador 1/Diagrama de bloques T1/Diagrama Bloques T1.pdf

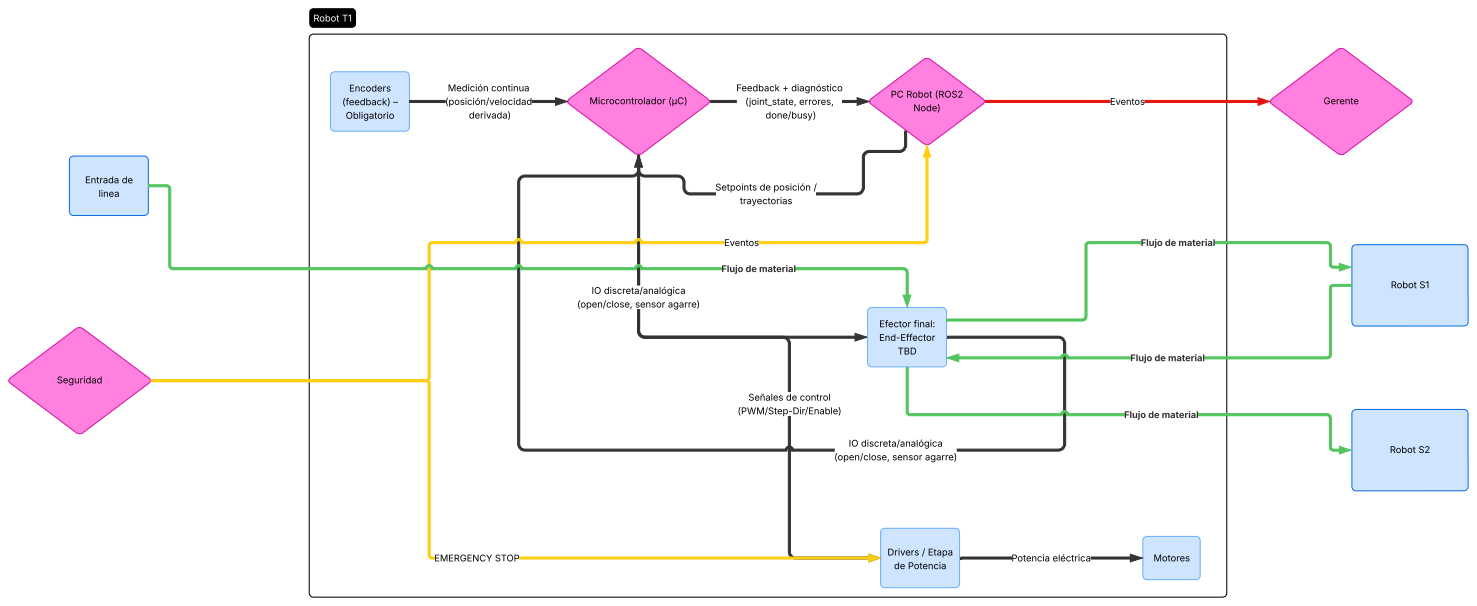
[picture p32: page 1]
Robot T1; PC Robot (ROS2 Node); Microcontrolador (µC); Drivers / Etapa; de Potencia; Motores; Encoders (feedback) ? Obligatorio; Feedback + diagnóstico (joint_state, errores, done/busy); Medición continua (posición/velocidad derivada); Potencia eléctrica; Efector final: End-Effector TBD; Seguridad; EMERGENCY STOP; Eventos; Gerente; Entrada de linea; Robot S1; Robot S2

Setpoints de posición /
trayectorias

Flujo de material

IO discreta/analógica
(open/close, sensor agarre)

Señales de control
(PWM/Step-Dir/Enable)
