estsamanthazota-cmd/Laboratorio-1-Robotica-UMNG/(commit log)

2026-03-18 Estructura completa respecto al diagrama de bloques
2026-03-18 Eliminada la carpeta
2026-03-19 Proceso Ensamblador uno
    [51306 Ball.sldprt, 51306 Housing washer.sldprt, 51306 Shaft washer.sldprt, 51306.sldasm, 628-2RS-BALL_mm.sldprt, 628-2RS-CAGE_mm.sldprt, 628-2RS-IR_mm.sldprt, 628-2RS-OR_mm.sldprt]
2026-03-19 Mis cambios antes de actualizar
    [51306 Ball.sldprt, 51306 Housing washer.sldprt, 51306 Shaft washer.sldprt, 51306.sldasm, 628-2RS-BALL_mm.sldprt, 628-2RS-CAGE_mm.sldprt, 628-2RS-IR_mm.sldprt, 628-2RS-OR_mm.sldprt]
2026-03-19 Doc: Elaboracion de read me
2026-03-19 Sincronizando planta de robots con cambios del equipo
2026-03-19 Agregados codigos .ino para control de motores y posicion
2026-03-19 Planos Robot SCARA Ensamblador 2
    Planos de Construcción Robot Ensamblador 2
2026-03-19 Planos Electricos
    Planos de Potencia del Robot Ensamblador 2
2026-03-19 Diagrama Ensamblador 2
    Diagrama de Bloques del robot SCARA Ensamblador 2
2026-03-19 Doc: Agregada seccion de ROS y estructura del workspace
